mikeysklar/c7k-toupee-comb-over/c7k-left-hand/c7k-left-hand.step

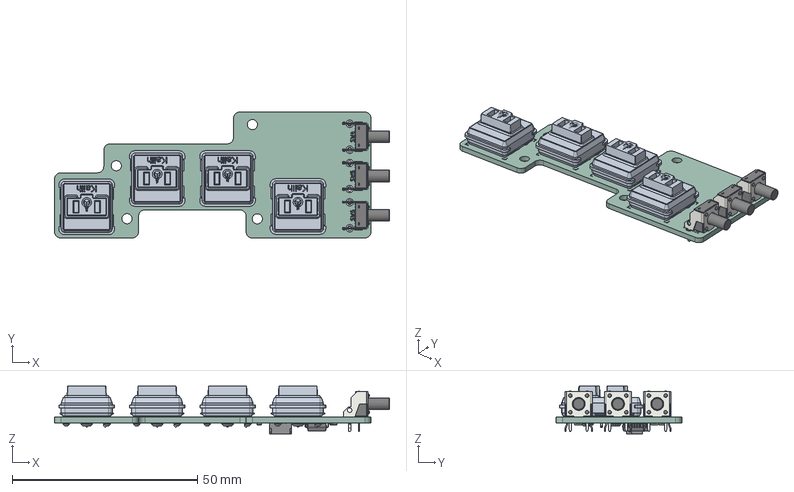
[picture p1: CAD file, 2025-05-09]
c7k-left-hand/c7k-left-hand.step
90.4 x 34.0 x 12.9 mm
SW_Tactile_SPST_Angled_PTS645Vx83-2LFS x 3
Kailh LP Choc Burnt Orange x 4
R_0805_2012Metric x 6
SSOP-20_5.3x7.2mm_P0.65mm
SPARKFUN_QWIIC_RIGHT_ANGLE
c7k-left-hand_pad
c7k-left-hand_silkscreen
c7k-left-hand_PCB
