mikeysklar/c7k-toupee-comb-over/case-comb-over/case-comb-over-nnv2-cover.stl

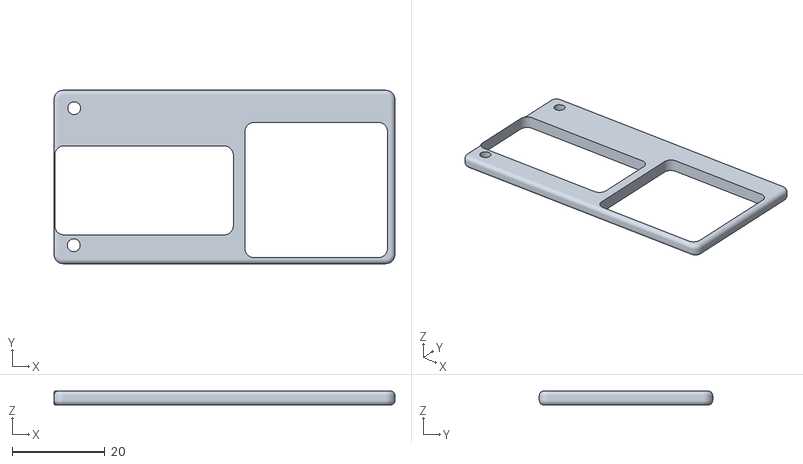
[picture p2: CAD file, 2025-05-17]
case-comb-over/case-comb-over-nnv2-cover.stl
73.4 x 37.3 x 3.00
