mikeysklar/c7k-toupee-comb-over/nnv2-toupee/nnv2-toupee-F_Cu.dxf

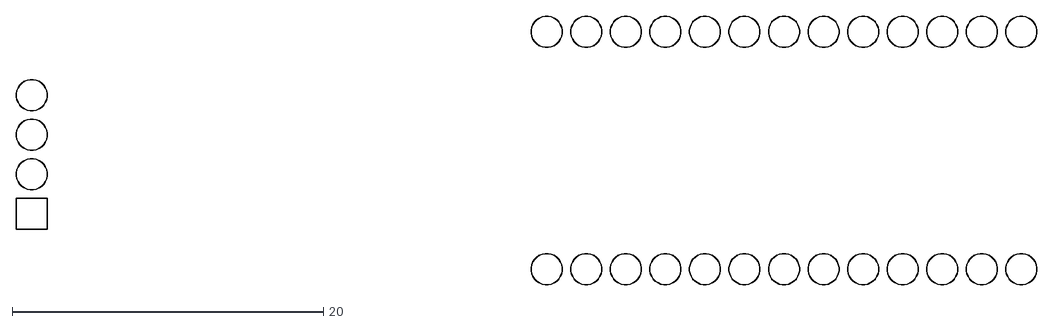
[picture p3: CAD file, 2025-05-17]
nnv2-toupee/nnv2-toupee-F_Cu.dxf
65.5 x 17.2
