mikeysklar/c7k-toupee-comb-over/nnv2-toupee/nnv2-toupee-Edge_Cuts.dxf

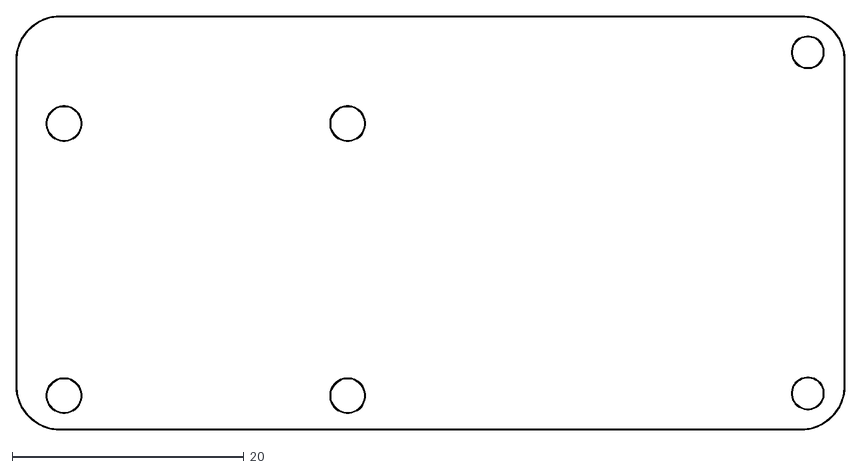
[picture p4: CAD file, 2025-05-17]
nnv2-toupee/nnv2-toupee-Edge_Cuts.dxf
71.6 x 35.8
