mikeysklar/c7k-toupee-comb-over/nnv2-toupee/nnv2-toupee-B_Cu.dxf

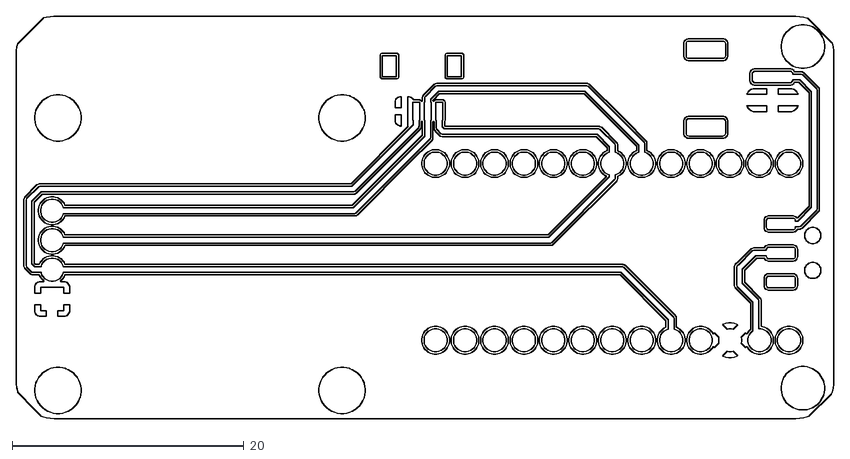
[picture p5: CAD file, 2025-05-17]
nnv2-toupee/nnv2-toupee-B_Cu.dxf
70.5 x 34.7
