mikeysklar/c7k-toupee-comb-over/(list of files, cad)

Other CAD files:
nnv2-toupee/nnv2-toupee-B_Mask.dxf
nnv2-toupee/nnv2-toupee-B_Paste.dxf
nnv2-toupee/nnv2-toupee-B_Silkscreen.dxf
nnv2-toupee/nnv2-toupee-F_Mask.dxf
nnv2-toupee/nnv2-toupee-F_Paste.dxf
nnv2-toupee/nnv2-toupee-F_Silkscreen.dxf
