mikeysklar/c7k-toupee-comb-over/c7k-left-hand/c7k-left-hand.kicad_pcb

## KiCad design c7k-left-hand/c7k-left-hand.kicad_pcb (2025-05-09)

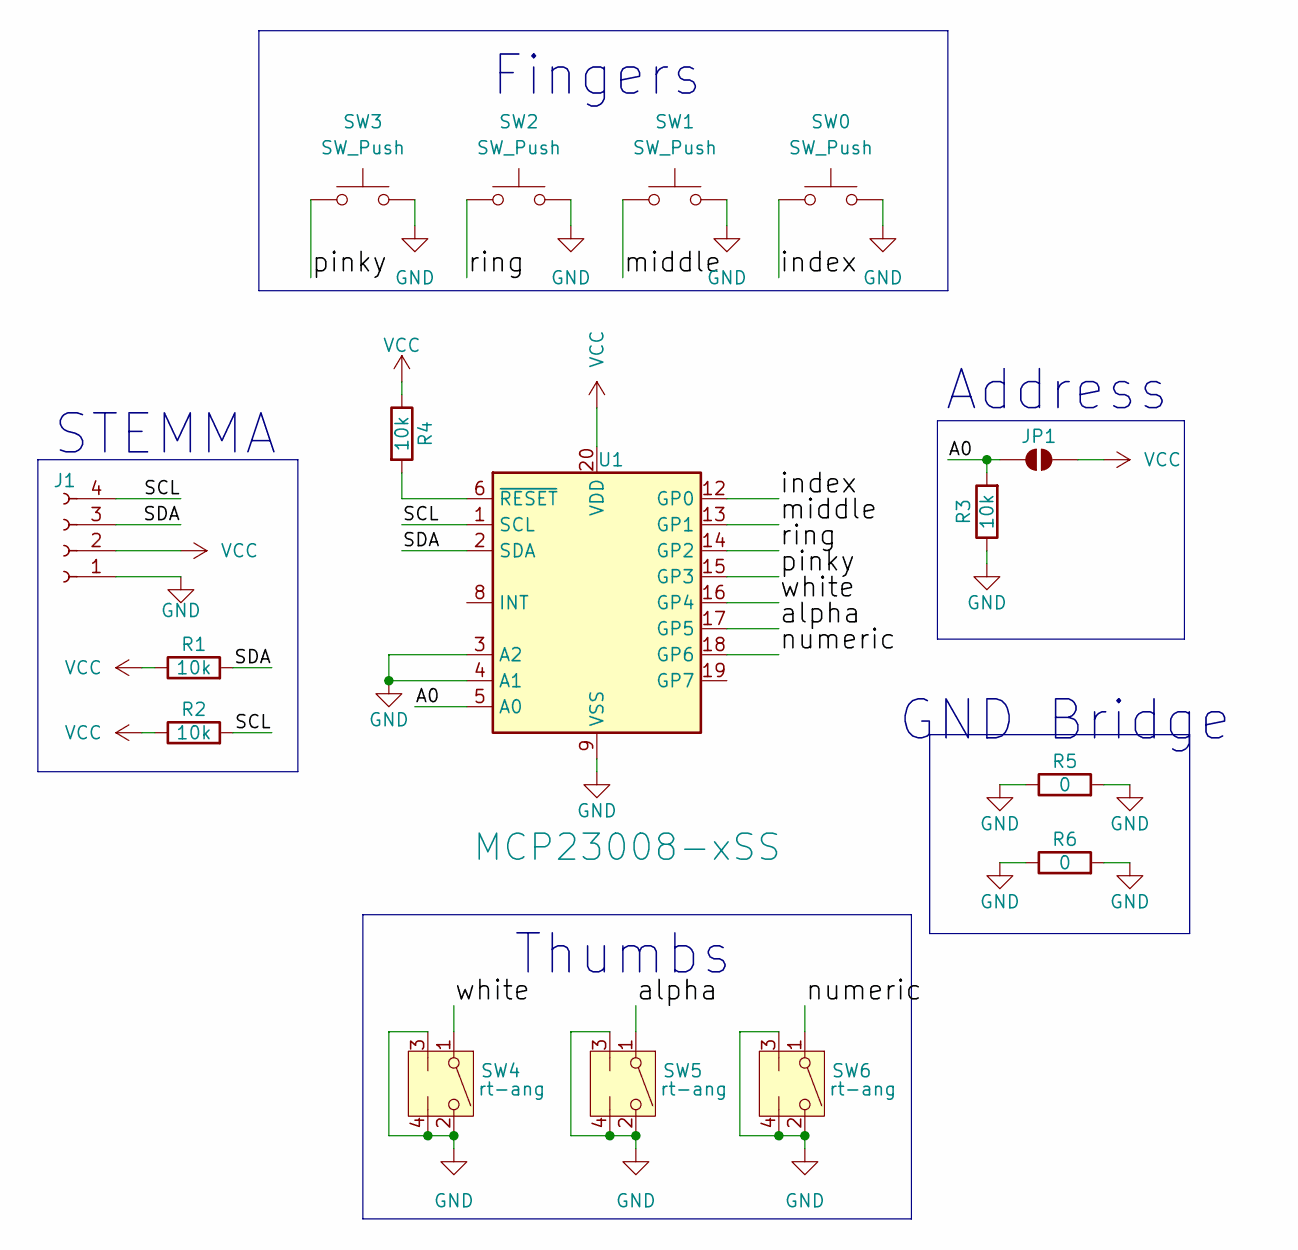
[picture p6: schematic c7k-left-hand.kicad_sch]

Parts:
J1: Conn_01x04_Socket; JST_SH_SM04B-SRSS-TB_1x04-1MP_P1.00mm_Horizontal
JP1: SolderJumper_2_Open; SolderJumper-2_P1.3mm_Open_TrianglePad1.0x1.5mm
R1, R2, R3, R4: 10k; R_0805_2012Metric_Pad1.20x1.40mm_HandSolder
R5, R6: 0; R_0805_2012Metric_Pad1.20x1.40mm_HandSolder
SW0, SW1, SW2, SW3: SW_Push; Kailh_socket_PG1350
SW4, SW5, SW6: rt-ang; SW_Tactile_SPST_Angled_PTS645Vx83-2LFS
U1: MCP23008-xSS; SSOP-20_5.3x7.2mm_P0.65mm

Connections:
/A0: JP1.1 (A), R3.2, U1.5 (A0)
/SCL: J1.4, R2.2, U1.1 (SCL)
/SDA: J1.3, R1.2, U1.2 (SDA)
/alpha: SW5.1, U1.17 (GP5)
/index: SW0.1, U1.12 (GP0)
/middle: SW1.1, U1.13 (GP1)
/numeric: SW6.1, U1.18 (GP6)
/pinky: SW3.1, U1.15 (GP3)
/ring: SW2.1, U1.14 (GP2)
/white: SW4.1, U1.16 (GP4)
GND: J1.1, R3.1, R5.1, R5.2, R6.1, R6.2, SW0.2, SW1.2, SW2.2, SW3.2, SW4.2, SW4.3 (L), SW4.4 (L), SW5.2, SW5.3 (L), SW5.4 (L), SW6.2, SW6.3 (L), SW6.4 (L), U1.3 (A2), U1.4 (A1), U1.9 (VSS)
unnamed: R4.2, U1.6 (~RESET)
VCC: J1.2, JP1.2 (B), R1.1, R2.1, R4.1, U1.20 (VDD)

Notes on the sheet:
GND Bridge
Fingers
Thumbs
Address
STEMMA

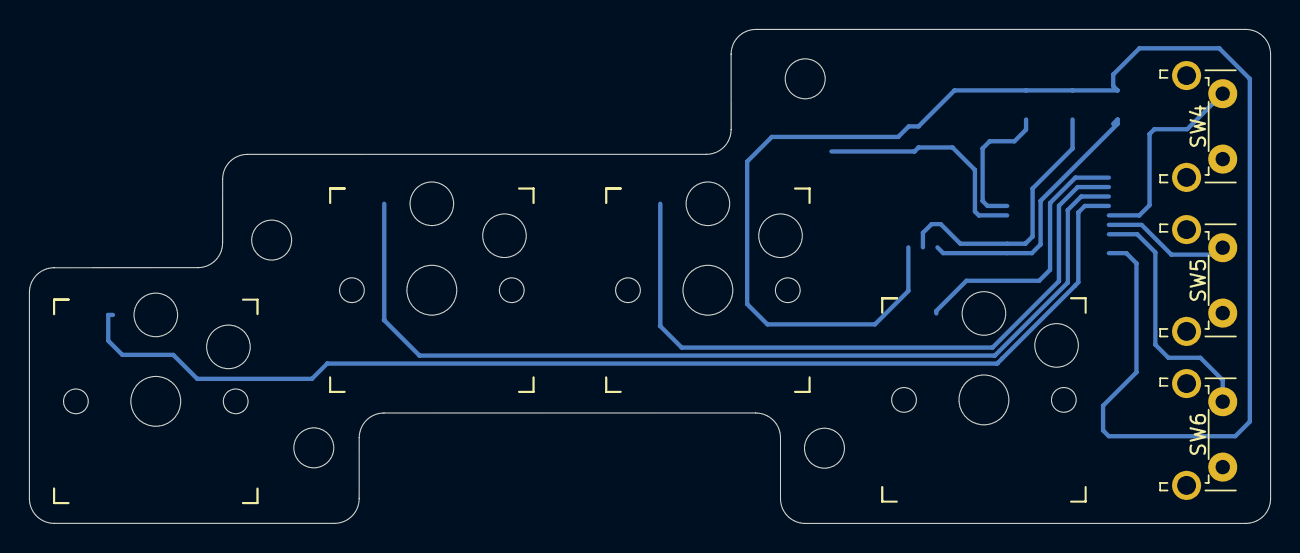
[picture p7: board c7k-left-hand.kicad_pcb from above]

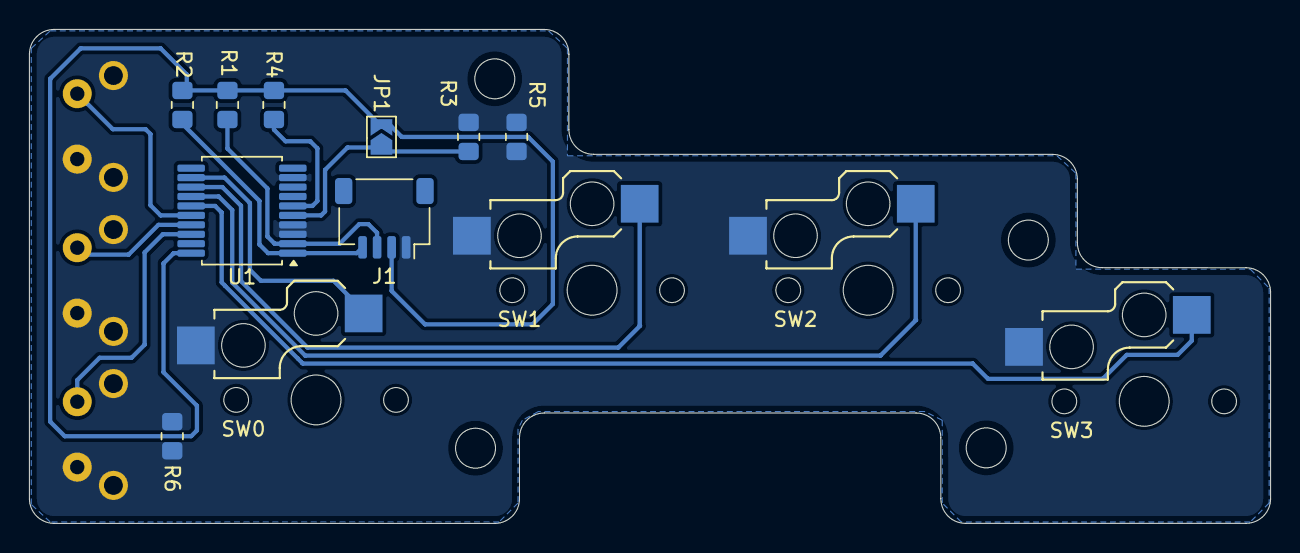
[picture p8: board c7k-left-hand.kicad_pcb from below]

Board: 2 copper layers, 85.4 x 34.0 mm, 16 parts (9 on the bottom side), 13 nets.
