mikeysklar/c7k-toupee-comb-over/nnv2-toupee/nnv2-toupee.kicad_pcb

## KiCad design nnv2-toupee/nnv2-toupee.kicad_pcb (2025-05-17)

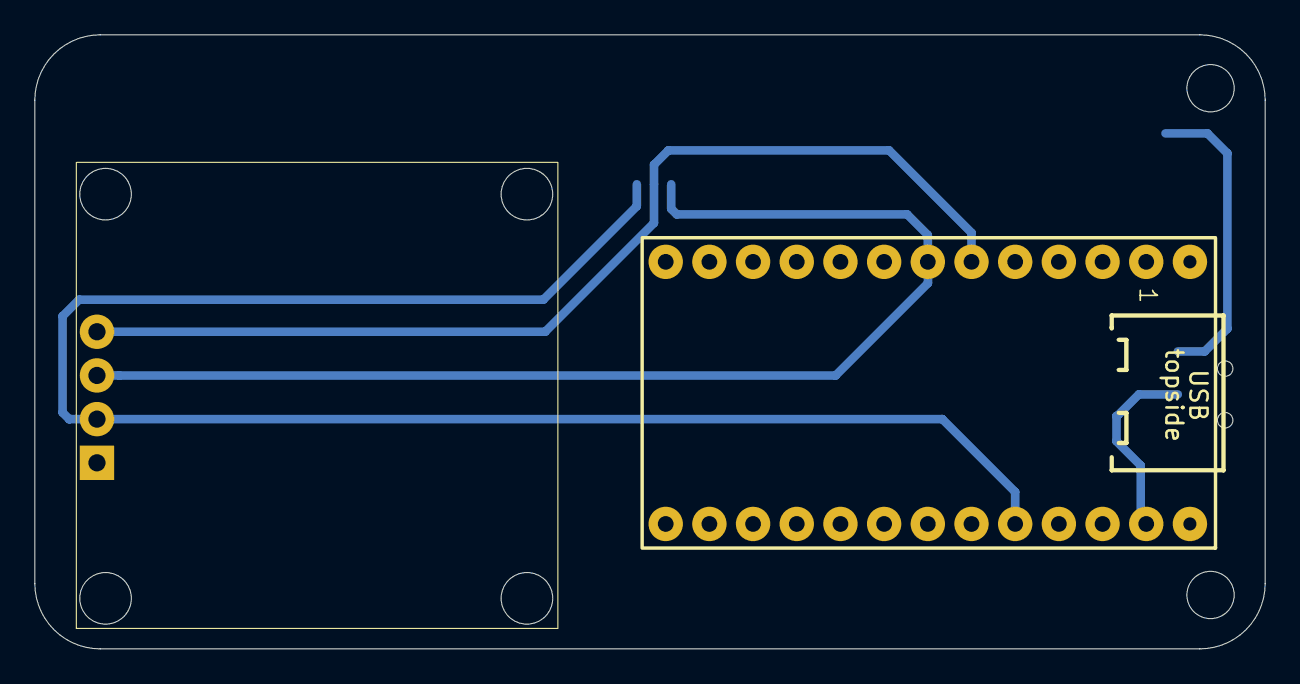
[picture p9: board nnv2-toupee.kicad_pcb from above]

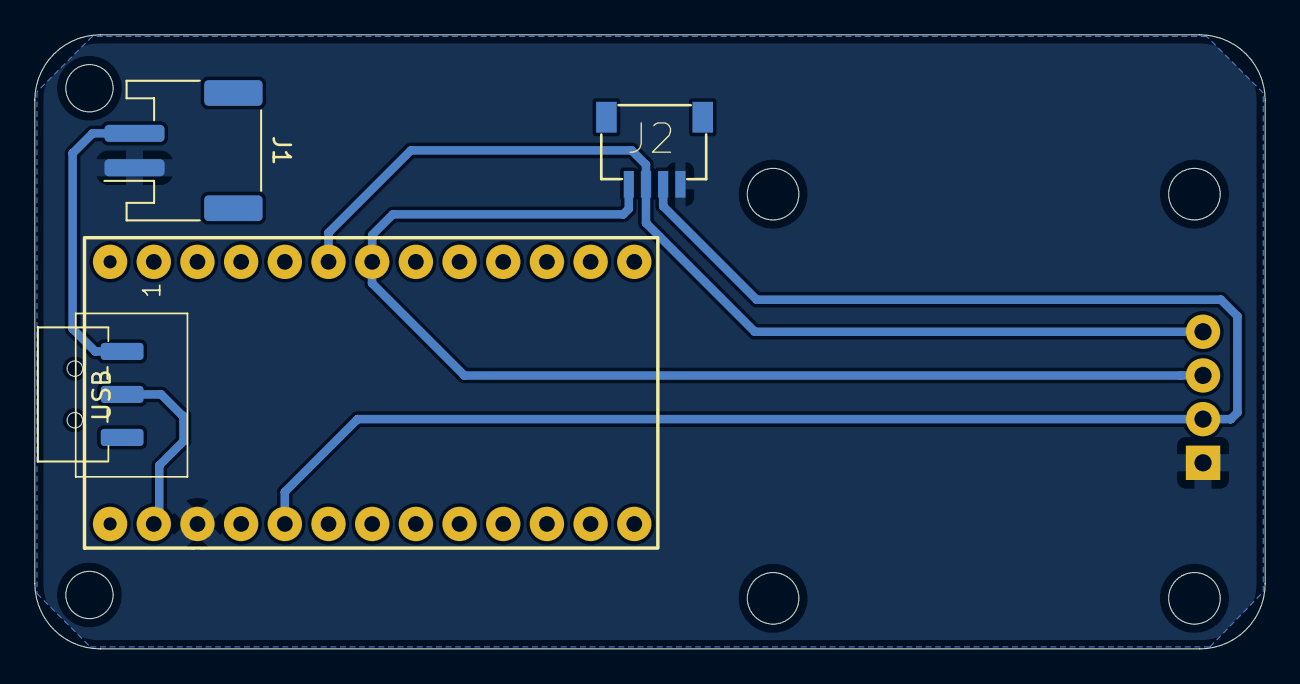
[picture p10: board nnv2-toupee.kicad_pcb from below]

Board: 2 copper layers, 71.5 x 35.7 mm, 5 parts (3 on the bottom side), 6 nets.

Parts:
J1: Conn_01x02_Socket; JST_PH_S2B-PH-SM4-TB_1x02-1MP_P2.00mm_Horizontal
J2: Conn_01x04_Socket; JST_SH4
J3: Conn_01x04_Pin; ssd1306-toupee
SW1: SW_SPST; Untitled
U1: Nice! Nano (ProMicro); SuperMini NRF52840

Connections:
/RAW: SW1.2 (B), U1.24 (5V)
/SCL: J2.4, J3.3, U1.6 (SCL(GP3))
/SDA: J2.3, J3.4, U1.5 (SDA(GP2))
/rawswitch: J1.2, SW1.1 (A)
GND: J1.1, J2.1, J3.1, U1.23 (GND)
VCC: J2.2, J3.2, U1.21 (3v3)
