mikeysklar/c7k-toupee-comb-over/(commit log)

2025-05-09 init commit
    [c7k-left-hand.kicad_pcb, c7k-left-hand.kicad_sch, c7k-left-hand.step, nnv2-toupee.kicad_pcb, nnv2-toupee.kicad_sch]
2025-05-11 working towards a comb over
    [nnv2-toupee.kicad_pcb]
2025-05-13 case hinge
2025-05-14 updating design files
    [c7k-left-hand-B_Cu.gbr, c7k-left-hand-B_Mask.gbr, c7k-left-hand-B_Paste.gbr, c7k-left-hand-B_Silkscreen.gbr, c7k-left-hand-Edge_Cuts.gbr, c7k-left-hand-F_Cu.gbr, c7k-left-hand-F_Mask.gbr, c7k-left-hand-F_Paste.gbr]
2025-05-17 walk away
    [case-comb-over-c7k-cover.stl, case-comb-over-center-plate.stl, case-comb-over-nnv2-bottom.stl, case-comb-over-nnv2-cover.stl]
2025-05-17 minor changes for board reprint
    [case-comb-over-nnv2-cover.stl, nnv2-toupee-B_Cu.dxf, nnv2-toupee-B_Mask.dxf, nnv2-toupee-B_Paste.dxf, nnv2-toupee-B_Silkscreen.dxf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]
